anorimaki/pi-metal-detector/doc/panel.png

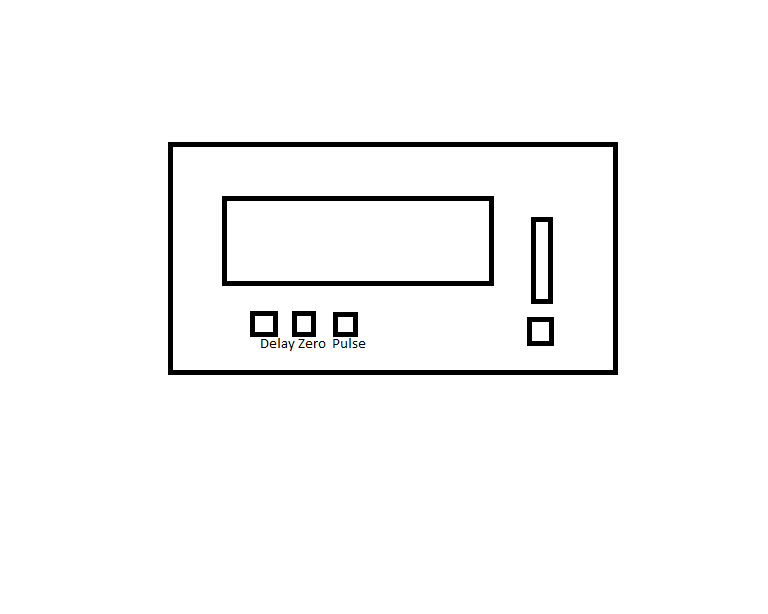
doc/panel.png
