anorimaki/pi-metal-detector/simulations/jfet_switch.asc

C1: cap; 10
C2: cap; 1n; V=20V
C3: cap; 1µ; V=20V
C4: cap; 1µ; V=20V
C5: cap; 1µ; V=20V
D1: diode; 1N4148
D2: diode; 1N4148
D3: schottky; RB481K
D4: diode; 1N4148
D5: schottky; RB481K
D6: schottky; RB481K
D7: schottky; RB481K
D8: schottky; RB481K
D9: schottky; RB481K
L1: ind2; 300µ; Rser=1 Cpar=40p
L2: ind2; 300µ; Rser=1 Cpar=40p
L3: ind2; 300µ; Rser=1 Cpar=40p
Q1: npn; BC547C
Q2: npn; BC547C
Q3: npn; BC547C
Q4: npn; BC547C
Q5: npn; BC547C
Q6: npn; BC547C
Q7: npn; BC547C
R1: res; 10K
R2: res; 100K
R3: res; 750
R4: res; 10K
R5: res; 1Meg
R6: res; 1K
R7: res; 510
R8: res; 320
R9: res; 10K
R10: res; 1K2
R11: res; 10K
R12: res; 1Meg
R13: res; 20K
R14: res; 470
R15: res; 20K
R16: res; 20K
R17: res; 20K
R18: res; 1K2
R19: res; 10K
R20: res; 20K
R21: res; 320
R22: res; 320
R23: res; 340
R24: res; 10K
R25: res; 40
R26: res; 100
R27: res; 900
R28: res; 340
R29: res; 10K
R30: res; 40
R31: res; 995
R32: res; 5
R33: res; 340
R34: res; 40
R35: res; 995
R36: res; 5
R37: res; 0
U1: opamp5
U2: LM318_NS
U3: irf740lc
U4: irf740lc
U5: opamp5
U6: BS250PLP
U7: BS170P
U8: irf740lc
V1: voltage; PULSE(4 9 10u 0 0 200u 50m)
V2: voltage; 9; Rser=0
V3: voltage; 9.00402
V4: voltage; 18
V5: voltage; 4
V6: voltage; PULSE(4 9 10u 0 0 200u 50m); Rser=100
V7: voltage; PULSE(4 9 10u 0 0 200u 50m)
V8: voltage; 10
V9: voltage; PULSE(0 5 0 0 0 500u 1m)
V10: voltage; PULSE(0 5 0 0 0 1m 2m)
V11: voltage; PULSE(0 5 0 0 0 1m 2m)
Named nets: 0, 9V, 18V, OUT, APPLIFIED, IN, 4V, AMP_OFFSET, 10V, COIL, MOS_BASE
.tran 10ms
