anorimaki/pi-metal-detector/(list of files, drawings)

Other design files:
schematics/metal_detector.pdsprj
