anorimaki/pi-metal-detector/piccode/include/config.h

/* 
 * File:   config.h
 * Author: David
 *
 * Created on 10 de mayo de 2016, 7:00
 */

#ifndef CONFIG_H
#define	CONFIG_H


void cnf_load();
void cnf_save_pulse_period();
void cnf_save_pulse_length();
void cnf_save_start_sample_delay();
void cnf_save_history_size();

#endif	/* CONFIG_H */
