anorimaki/pi-metal-detector/piccode/src/modesetup.c

#include "main.h"
#include "modesetup.h"
#include "usermodes.h"
#include "display.h"
#include "coil.h"
#include "inbuttons.h"
#include "inencoder.h"
#include "config.h"


#define SETUP_PULSE_LOOP_PAUSE				1		//In ms

#define SETUP_PULSE_READ_REFERENCE_PERIOD	2000	//In ms
#define SETUP_PULSE_READ_REFERENCE_COUNTER \
		(SETUP_PULSE_READ_REFERENCE_PERIOD/SETUP_PULSE_LOOP_PAUSE)

#define SETUP_PULSE_UPDATE_DISPLAY_PERIOD	100		//In ms
#define SETUP_PULSE_UPDATE_DISPLAY_COUNTER \
		(SETUP_PULSE_UPDATE_DISPLAY_PERIOD/SETUP_PULSE_LOOP_PAUSE)

void mode_setup_pulse()
{
	static int1 show_mode = DSP_SHOW_VOLTS;
	
	dsp_setup_coil_pulse_init();
	
	encoder_set_increment( COIL_MIN_PULSE_LENGTH, COIL_MAX_PULSE_LENGTH,
						 INCREMENT_AUTO_RATE );
	
	int16 read_reference_counter = SETUP_PULSE_READ_REFERENCE_COUNTER;
	int8 update_display_counter = SETUP_PULSE_UPDATE_DISPLAY_COUNTER;
	
	int16 initial_pulse_length = coil_get_pulse_length();
	
	delay_us( COIL_READ_PEAK_PULSE_PERIOD );
	int16 reference_5v = 28;
	
	coil_read_peak_begin();
	
	while (TRUE) {
		int8 mode_button = mode_check_buttons();
		if ( mode_button == BUTTON_SETUP_PULSE ) {
			++show_mode;		
		}
		else if ( mode_button != NO_MODE_BUTTON ) {
			coil_end();
			if ( initial_pulse_length != coil_get_pulse_length() ) {
				cnf_save_pulse_length();
			}
			return;
		}
		
		coil_set_pulse_length( encoder_increment( coil_get_pulse_length() ) );
		
		if ( coil_fetch_result() && (--read_reference_counter == 0) ) {
			coil_sleep();
			delay_us( COIL_READ_PEAK_PULSE_PERIOD/2 );
		//	reference_5v = coil_peak_ref();
			coil_wakeup();
			read_reference_counter = SETUP_PULSE_READ_REFERENCE_COUNTER;
		}

		if ( --update_display_counter == 0 ) {
			dsp_setup_coil_pulse( coil.result.value, reference_5v, show_mode);
			update_display_counter = SETUP_PULSE_UPDATE_DISPLAY_COUNTER;
		}
		
		delay_ms( SETUP_PULSE_LOOP_PAUSE );
	}
}


#define SETUP_AUTOZERO_THRES_LOOP_PAUSE		5		//In ms

#define SETUP_AUTOZERO_THRES_DISPLAY_PERIOD	100		//In ms
#define SETUP_AUTOZERO_THRES_DISPLAY_COUNTER \
		(SETUP_AUTOZERO_THRES_DISPLAY_PERIOD/SETUP_AUTOZERO_THRES_LOOP_PAUSE)

#define SETUP_AUTOZERO_NOISE_RESET_COUNTER	10

void mode_setup_autozero_threshold() 
{
	dsp_setup_autozero_threshold_init();
	
	encoder_set_increment( 0, MODE_SETUP_AUTOZERO_THRESHOLD_MAX,
						 INCREMENT_AUTO_RATE );
	
	int16 noise = 0;
	int8 noise_reset_counter = SETUP_AUTOZERO_NOISE_RESET_COUNTER;
	int8 update_display_counter = SETUP_AUTOZERO_THRES_DISPLAY_COUNTER;
	
	coil_read_decay_begin();

	while (TRUE) {
		if ( mode_changed() ) {
			coil_end();
			return;
		}
		
		if ( buttons_is_pressed(BUTTON_AUTO) ) {
			coil.auto_zero_threshold = noise+3;
		}

		coil.auto_zero_threshold = encoder_increment( coil.auto_zero_threshold );
		
		coil_fetch_result();
		
		if ( coil.result.noise>noise )	 //Take max noise signal to show
			noise = coil.result.noise;
		
		if ( --update_display_counter == 0 ) {
			dsp_setup_autozero_threshold( noise );
			
			if ( --noise_reset_counter == 0 ) {
				noise_reset_counter = SETUP_AUTOZERO_NOISE_RESET_COUNTER;
				noise = 0;
			}
			
			update_display_counter = SETUP_AUTOZERO_THRES_DISPLAY_COUNTER;
		}
		
		delay_ms( SETUP_AUTOZERO_THRES_LOOP_PAUSE );
	}
}


#define SETUP_RESPONSE_TIME_LOOP_PAUSE				5		//In ms

#define SETUP_RESPONSE_TIME_UPDATE_DISPLAY_PERIOD	100		//In ms
#define SETUP_RESPONSE_TIME_UPDATE_DISPLAY_COUNTER \
	(SETUP_RESPONSE_TIME_UPDATE_DISPLAY_PERIOD/SETUP_RESPONSE_TIME_LOOP_PAUSE)

void mode_setup_response_time() 
{
	dsp_setup_response_time_init();
	
	int8 update_display_counter = SETUP_RESPONSE_TIME_UPDATE_DISPLAY_COUNTER;
	
	int1 selected = DSP_SELECTION_PULSE_PERIOD;
	encoder_set_increment( COIL_MIN_PULSE_PERIOD_COUNT, 
						COIL_MAX_PULSE_PERIOD_COUNT, INCREMENT_AUTO_RATE );
	
	int16 initial_pulse_period = coil.pulse_period;
	int8 initial_samples_history_size_log = coil.samples_history_size_log;
	
	while (TRUE) {
		if ( mode_changed() ) {
			if ( initial_pulse_period != coil.pulse_period ) {
				cnf_save_pulse_period();
			}
			if ( initial_samples_history_size_log != 
					coil.samples_history_size_log ) {
				cnf_save_history_size();
			}
			return;
		}
		
		if ( buttons_is_pressed(BUTTON_AUTO) ) {
			++selected;
			
			if ( selected==DSP_SELECTION_PULSE_PERIOD ) {
				encoder_set_increment( COIL_MIN_PULSE_PERIOD_COUNT, 
							COIL_MAX_PULSE_PERIOD_COUNT, INCREMENT_AUTO_RATE );
			}
			else {
				encoder_set_increment( SAMPLES_HISTORY_MIN_SIZE_LOG, 
							SAMPLES_HISTORY_MAX_SIZE_LOG, INCREMENT_AUTO_RATE );
			}
		}

		if ( selected==DSP_SELECTION_PULSE_PERIOD ) {
			coil.pulse_period = encoder_increment( coil.pulse_period );
		}
		else {
			coil.samples_history_size_log = 
						encoder_increment( coil.samples_history_size_log );
		}
		
		if ( --update_display_counter == 0 ) {
				//Only update user interface every 8 loops
			dsp_setup_response_time( selected );
			update_display_counter = SETUP_AUTOZERO_THRES_DISPLAY_COUNTER;
		}
		
		delay_ms( SETUP_RESPONSE_TIME_LOOP_PAUSE );
	}
}
