anorimaki/pi-metal-detector/piccode/include/mathutil.h

#ifndef MATHUTIL_H
#define	MATHUTIL_H

#define CHECKED_ADD(a, b, max) ((max-a)>b ? a+b : max)
#define CHECKED_SUB(a, b, min) ((a-min)>b ? a-b : min)

signed int32 math_change_range(signed int16 value, int16 max_value, 
								int16 new_max_value);

signed int32 math_change_sqrt_range(signed int16 value, int16 max_value, 
								int16 new_max_value);

signed int32 math_change_log_range(signed int16 value, int16 max_value, 
								int16 new_max_value);

#endif
