anorimaki/pi-metal-detector/piccode/include/inbuttons.h

#ifndef INSWITCH_H
#define	INSWITCH_H

struct InButton {
    int1 state;                 // ON/OFF state
    int1 changed;
    int16 state_time;           // ms that switch has been in this state
	int8 change_confident_count;
};


#define BUTTONS_SIZE       6

extern struct InButton in_buttons[BUTTONS_SIZE];

#define BUTTON_MAIN             1
#define BUTTON_SETUP_DELAY      0
#define BUTTON_SETUP_AUTOZERO	2
#define BUTTON_SETUP_PULSE      3
#define BUTTON_SETUP_RESPONSE   4
#define BUTTON_AUTO             5

void buttons_init();

void buttons_update( int8 switches_state );

int1 buttons_wait_for_release_timeout( int8 sw, int16 max_push_time );
void buttons_wait_for_release( int8 sw );

int1 buttons_is_pressed( int8 sw );

#endif
