anorimaki/pi-metal-detector/piccode/src/secure_math.h

/* 
 * File:   secure_math.h
 * Author: David
 *
 * Created on 22 de junio de 2016, 7:26
 */

#ifndef SECURE_MATH_H
#define	SECURE_MATH_H

#define CHECKED_SUM(a, b, max) ((max-a)>b ? max : a+b)

#endif	/* SECURE_MATH_H */
