anorimaki/pi-metal-detector/(commit log)

2015-10-22 - First commit
    [metal_detector.pdsprj]
2015-12-26 Creado vinculo entre el proyecto ccs y el proteus
    [metal_detector.pdsprj]
2016-03-21 - Añadido amplificador al esquema
    [metal_detector.pdsprj]
2016-03-21 - Corregido proyecto de código en el proteus
    [metal_detector.pdsprj]
2016-03-24 - Añadido código para ADC
    [metal_detector.pdsprj]
2016-03-24 - Añadido al esquema integrador
    [metal_detector.pdsprj]
2016-03-24 - Añadido restador al esquema
    [metal_detector.pdsprj]
2016-04-12 - Añadida simulación de jfet como switch
2016-04-15 - Añadidos más componentes a la simulación
2016-04-16 - CAmbiado PIC a 4-9V en al simulador
2016-05-06 - Añadido LCD - Añadidos más componentes a la simulación
    [metal_detector.pdsprj]
2016-05-06 Corregido proyecto corrupto
    [metal_detector.pdsprj]
2016-05-11 - Esquema: Añadida captura del pico de la bobina - Código: Empezada estructuración de fuentes y funcionalidad de display y lectura de botones.
    [metal_detector.pdsprj]
2016-05-11 - Continuada la primera versión del código
2016-05-12 - Corregidos errores sintácticos.
    [config.c, config.h, display.c, display.h, input.c, main.c, pimetaldec.c]
2016-05-13 - Corregidos todos los errores sintácticos
    [display.c, input.c, main.c, pimetaldec.c, setup.c]
2016-05-20 - Pantalla de setup del pulso de la bobina.
    [metal_detector.pdsprj]
2016-05-23 - Cambiado integrador por un amplificador inversor simple.
    [metal_detector.pdsprj]
2016-05-25 - Empezada refactorización para tener mejor respuesta a los botones - Renombrados ficheros y metodos
2016-05-25 - Continuación de la refactorización anterior
2016-05-26 - Completada refactorización del código. - Se ha incrementado la frecucia de pulsos y el historial con lo que se ha ganado en velocidad de respuesta y estabilidad. - Buena respuesta a los botones.
2016-05-29 - Empezado a añadir tono acustico.
    [metal_detector.pdsprj]
2016-06-04 - Cambiado cristal por oscilador interno. - Incrementada la frecuencia de muestreo a 66Hz - Incrementado historial a 32 muestras. - Corregido el tiempo mínimo de retraso de las muestras debido a que 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
    [metal_detector.pdsprj]
2016-06-11 - Implementado charlieplexing en los botones para tener más botones (uno por modo de setup)
    [metal_detector.pdsprj]
2016-06-22 - Corregido normalización de los valores de señal negativos. - Incrementada la frecuencia de compobación de la entrada.
    [metal_detector.pdsprj]
2016-06-22 - Empezado a añadir el código para cambiar los botones de inc/dec por un encoder incremental.
2016-06-23 - Primera versión del codigo para el encoder. Falta afinar los tiempos
2016-06-23 - Separada la funcionalidad de los botones y el encoder en ficheros separados. - Rafactorizados los nombres de las funciones y structuras de botones y encoder.
2016-06-24 - Renombrados: switch -> buttons - Añadida mayor frecuencia de muestreo para las entradas del encoder que para los botones.
2016-06-24 - Encoder funcional con cambio de velocidad.
2016-06-25 - Empezadas mejoras en la interfaz del display - Añadida estadisticas de ruido basadas en la desviación estándar
    [metal_detector.pdsprj]
2016-06-25 - Añadido mode_autoset_sample_delay para visualizar las diferentes señales según el delay
2016-06-26 - Añadidas mejoras en la interfaz del display
    [metal_detector.pdsprj]
2016-06-26 - Limpieza de código
2016-07-02 - Empezado PCB
    [metal_detector.pdsprj]
2016-07-05 - Continuado PCB
    [metal_detector.pdsprj]
2016-07-13 - Cambiado display de la señal. En vez de enseñar un nivel proporcial es cuadratica para dar más relevancia a las pequeñas señales. - Primera versión de PCB
    [metal_detector.pdsprj]
2016-07-15 - Cambiado asignación de pines segun esquema.
    [metal_detector.pdsprj]
2016-07-18 - Añadido display del voltaje de la batería
2016-07-23 - Añadido conector para interruptor - Añadido circuteria para estado de bateria - Corregido circuito de pico de voltaje de la bobina.
    [metal_detector.pdsprj]
2016-07-24 - Decrementado el tiempo de adquisición del ADC para obtener un resultado más excacto. - Cambiados asignación de PINs del PIC para debido al routing de PCB - Incrementada corrección del tiempo de sam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
    [metal_detector.pdsprj]
2016-07-25 - Cambiado tono acustico al CCP5 - Empezado a añadir soporte para tipo de encoder ALPS. Nuevo PIN de entrada.
    [metal_detector.pdsprj]
2016-07-28 - Lineas de encoder dedicadas para adaptarlo al tipo ALPS. - PCB principal acabado
    [metal_detector.pdsprj]
2016-07-31 - Hechos PCB de la botoneta y la intefaz con el LCD - Reconfigurados pines del PIC para facilitar el routing del PCB - Cabiado el timepo de adquisición del ADC a manual para poder especificar 1us (qu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
    [metal_detector.pdsprj]
2016-08-02 - Corregido error en la medición de la tensión de la bateria. El divisor resistivo estaba invertido en el esquema. - Código: Limpiado el módulo de ADC. Ahora se configura primero el ADC antes de sele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
    [metal_detector.pdsprj]
2016-08-07 - Incrementada velocidad de respuesta: - Incrementada frecuencia de pulsos - Bajado el historial de valores para hacer la media de la lectura (32 -> 8) - Añadida auto-calibración inicial - Bajda frec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
2016-08-07 - Empezado soporte de la frecuencia de pulsos basado en timers y no en delays para un mejor ajuste de esta frecuencia.
2016-08-08 - Corrección en la nueva implementación del encoder_increment. - Otras correciones menores.
2016-08-09 - Cambiado el 'special event trigger' para activar el ADC. Ahora se usa el timer1 en vez del ECCP1. Parece que ahora funciona correctamente. Seguramente el ECCP1 estaba reiniciando la operación de AD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
    [adconvert.c, coil.c, main.c, main.h, modesetup.c, picconfig.h, samples.h, tone.c]
2016-08-09 - Corregido error en la lectura de los botones. No se estaba dando suficiente tiempo para que la línea 2 de multiplexado se recuperase antes de leer.
    [inbuttons.h, input.c]
2016-08-09 - Limipieza menor de código
2016-08-09 - Corregida lectura de la referencia de 5v en el modo de configuración del ancho de pulso.
2016-08-09 - Corregida configuración del ancho de pulso. Se podía sobrepasar el mínimo.
2016-09-14 - Empezado a añadir configuración del tiempo de respuesta basada en el tamaño del historial de 'samples' y la frecuencia de los pulsos. - Refactorizado módulo display para soportar más de una línea d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
2016-09-27 - Continuada configuración del tiempo de respuesta basada en el tamaño del historial de 'samples' y la frecuencia de los pulsos. - Intercambiados timer4 y timer0. Ahora el timer4 se utiliza en para e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
2016-09-28 - Ajustado valor mínimo de periodo de pulso
2016-10-01 - Cambiado wait para generar el pulso de la bobina por la interrupción del timer 1. No acaba de funcionar de manera precisa.
    [metal_detector.pdsprj]
2016-10-07 - Refactorizado samples para cálculo de la suma de los cuadrados fuera de la interrupcción del ADC. - El cálculo del cuadrado implica una llamada a @MUL3232 desde la interrupción. El compìlador desha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
2016-10-12 - Correción de bug en samples. - Optimización: Reemplazo del operador * por la función _mul para las operaciones con operandos de 16bits y resultado de 32.
    [samples.c]
2016-10-13 Modo de configuración del ancho de pulso: - Fijado el periodo de pulso. - Simplificado bucle principal.
2016-10-13 - Ajustados valores de mínimo y máximo de espera para lectura de la señal de caida. - Correcciones en la visualización del valor mínimo en los rangos. - Modo ancho de pulso: Fijado el valor de refere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
    [metal_detector.pdsprj]
2016-10-16 - Mejorado el incrementos de rangos para que la velocidad del encoder se aplique de forma más lineal. - Incrementado el tiempo scan del encoder a 2ms. El periodo mínimo del encoder está sobre los 10 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
2016-10-25 - Configuración de parámetros gruarda en EEPROM al cambiar de modo
2016-10-26 - Eliminado auto_zero_threshold de la configuración en la EEPROM. Se calcula en la calibración inicial. - Mejorado timepo de respuesta en la visualización de los múltiples tiempos de caida
2016-11-02 - Mejorado timepo de respuesta en la visualización de los múltiples tiempos de caida - Añadida inercia al display del ruido en el modo principal
2016-11-02 - Añadida inercia al display del ruido en el modo zero threshold
2016-11-06 - Añadidos esquemas PDF
    [metal_detector.pdsprj]
2016-11-06 - Cambiado circuito de audio para evitar grandes diferencias de variación del consumo en la activación del circuito. La diferencia de consumo cuando estaba activado y cuando estaba desactivado afecta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
    [metal_detector.pdsprj]
2016-11-16 - Mejorado el control de tono de detección: - Optimizada la función tone_apply - Utilizado el timer4 como base de timepo para el timer3 (usando Gate3) - Cambiado a timer2 para calcular el periodo de 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
2016-11-26 - Cambiada implementación del tono de detección. En vez de variar en frequencia, se genera un tono fijo que se repite. El intervalo entre tonos depende de la intensidad de la señal.
